twfth9/Krankenwagen_PCB_Demo/Production/Krankenwagen_PCB.step

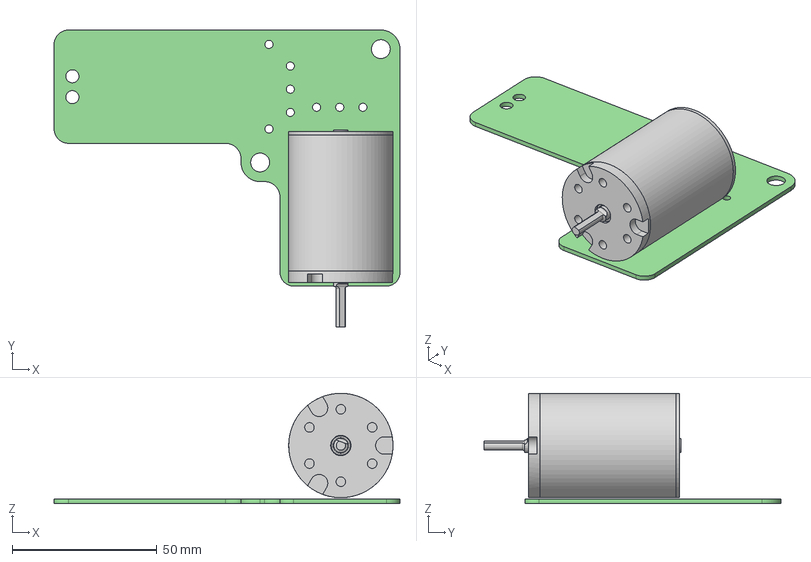
[picture p1: CAD file, 2022-10-02]
Production/Krankenwagen_PCB.step
119.4 x 102.5 x 38.1 mm
Krankenwagen_PCB PCB
