twfth9/Krankenwagen_PCB_Demo/Documentation/Krakenwagen 2021 Wiring Diagram.png

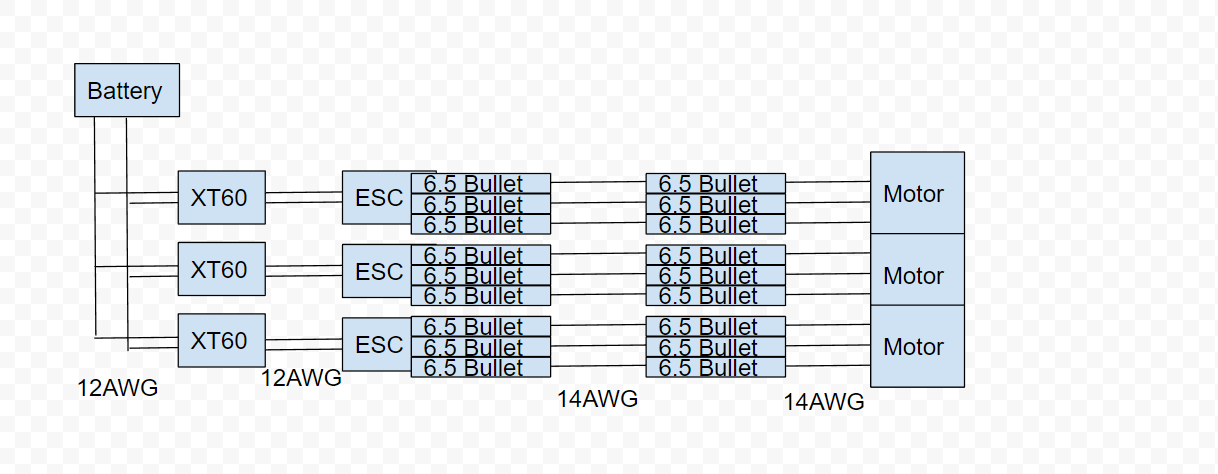
Documentation/Krakenwagen 2021 Wiring Diagram.png
