twfth9/Krankenwagen_PCB_Demo/Documentation/Drive SubAssembly.pdf

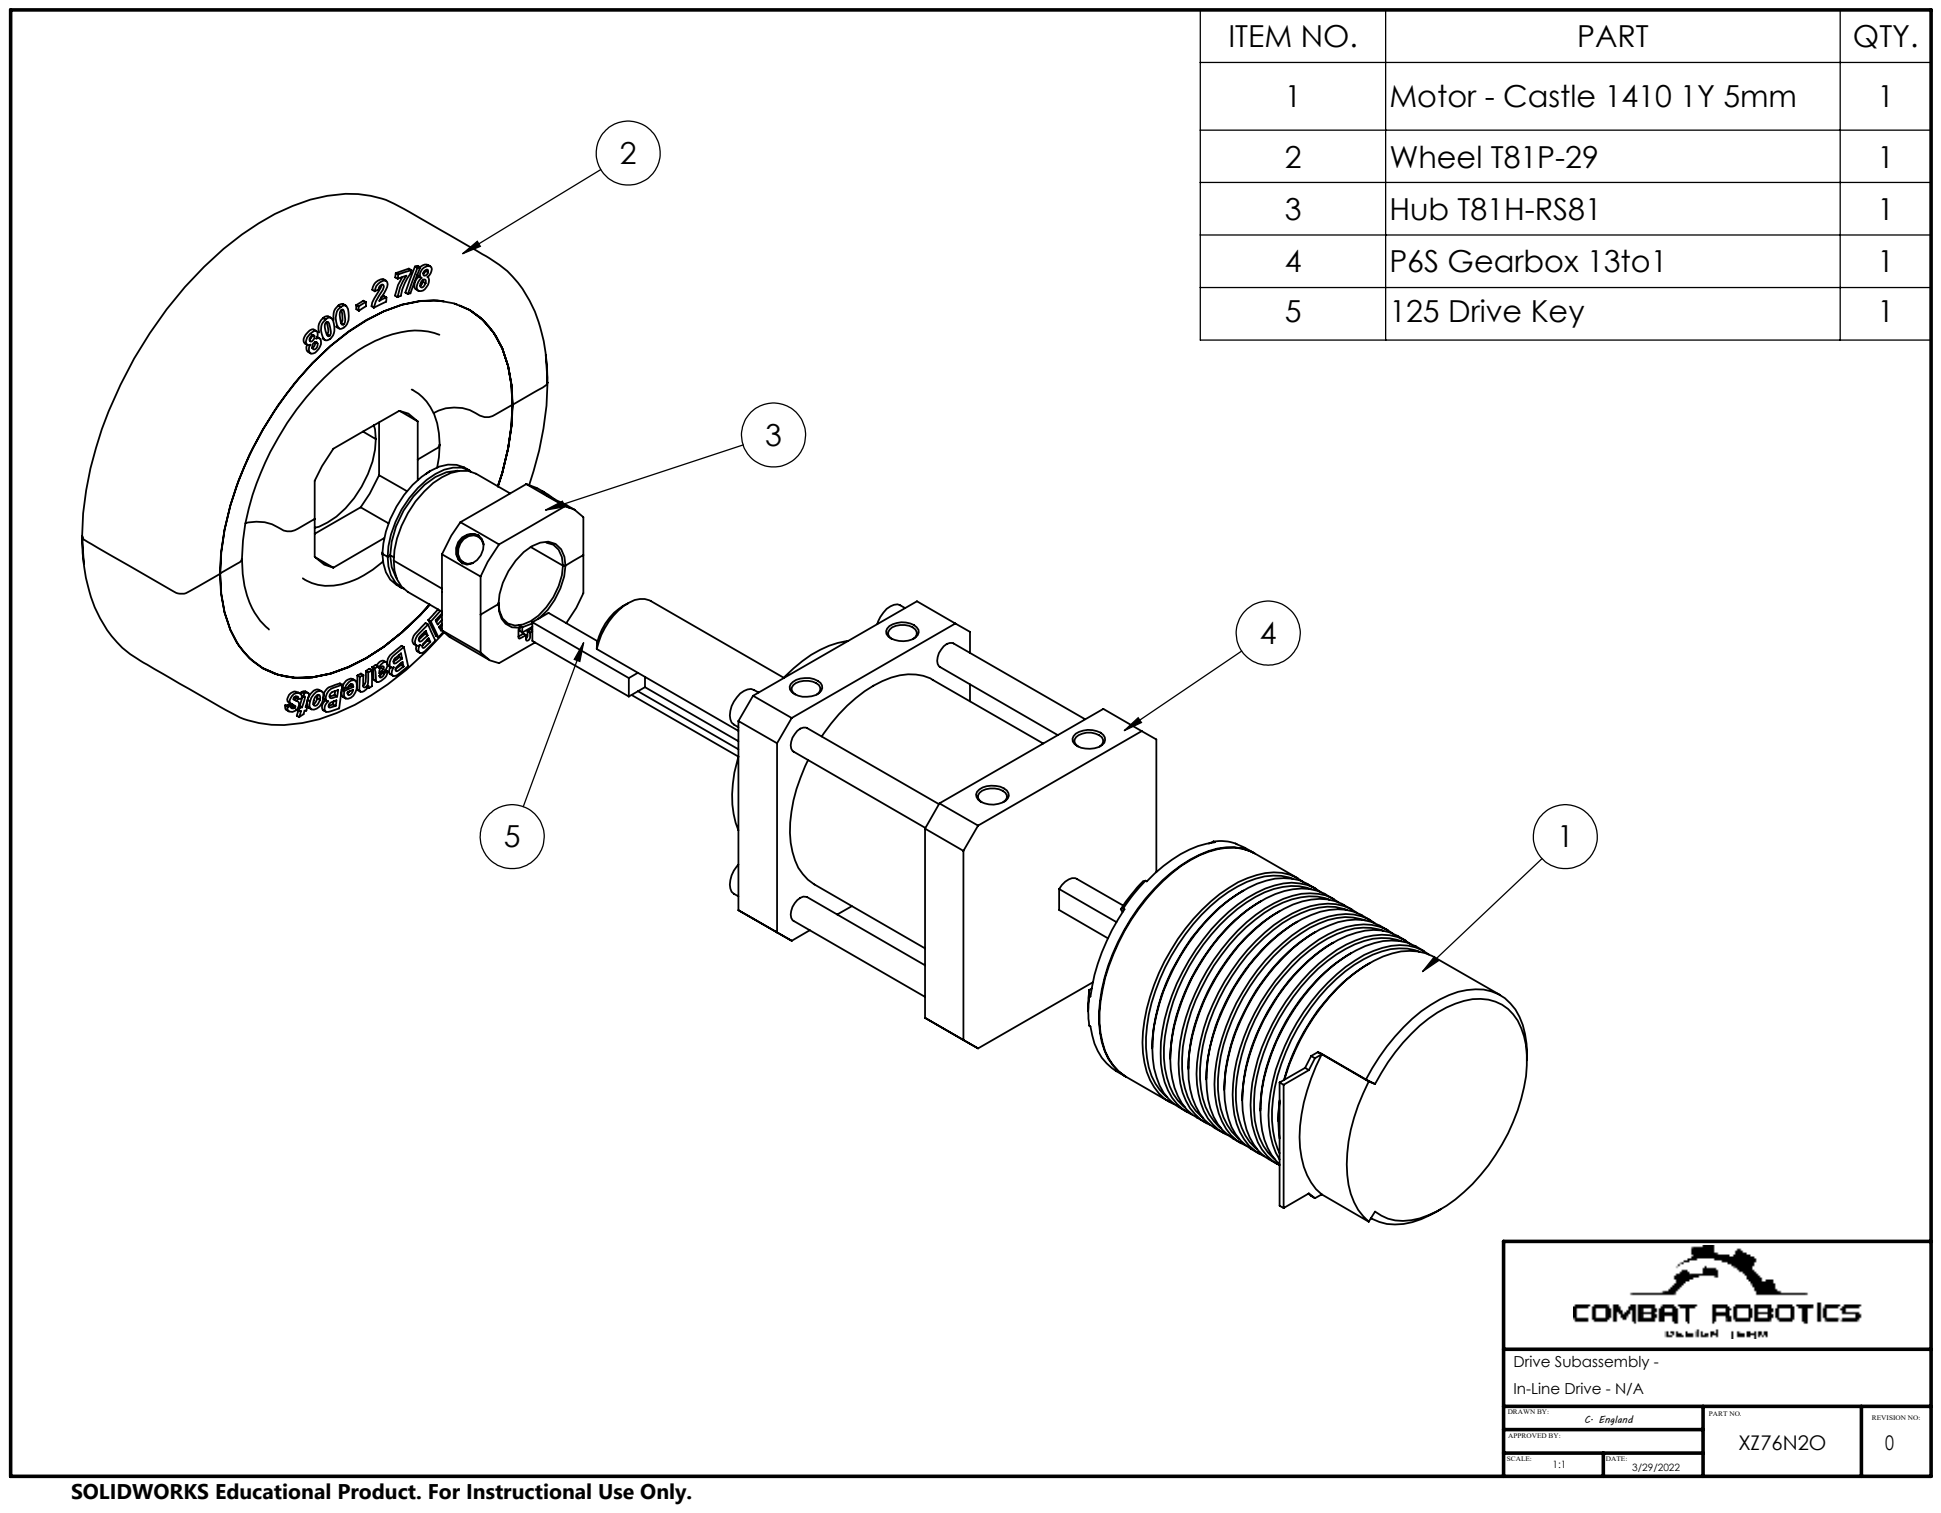
[picture p3: page 1]
0 SCALE:; DATE:; DRAWN BY:; PART NO.; C. England; REVISION NO:; XZ76N2O APPROVED BY:

ITEM NO. | PART | QTY.
1 | Motor - Castle 1410 1Y 5mm | 1
2 | Wheel T81P-29 | 1
3 | Hub T81H-RS81 | 1
4 | P6S Gearbox 13to1 | 1
5 | 125 Drive Key | 1

Drive Subassembly -
In-Line Drive - N/A

SOLIDWORKS Educational Product. For Instructional Use Only.
