twfth9/Krankenwagen_PCB_Demo/Documentation/Main Assembly.pdf

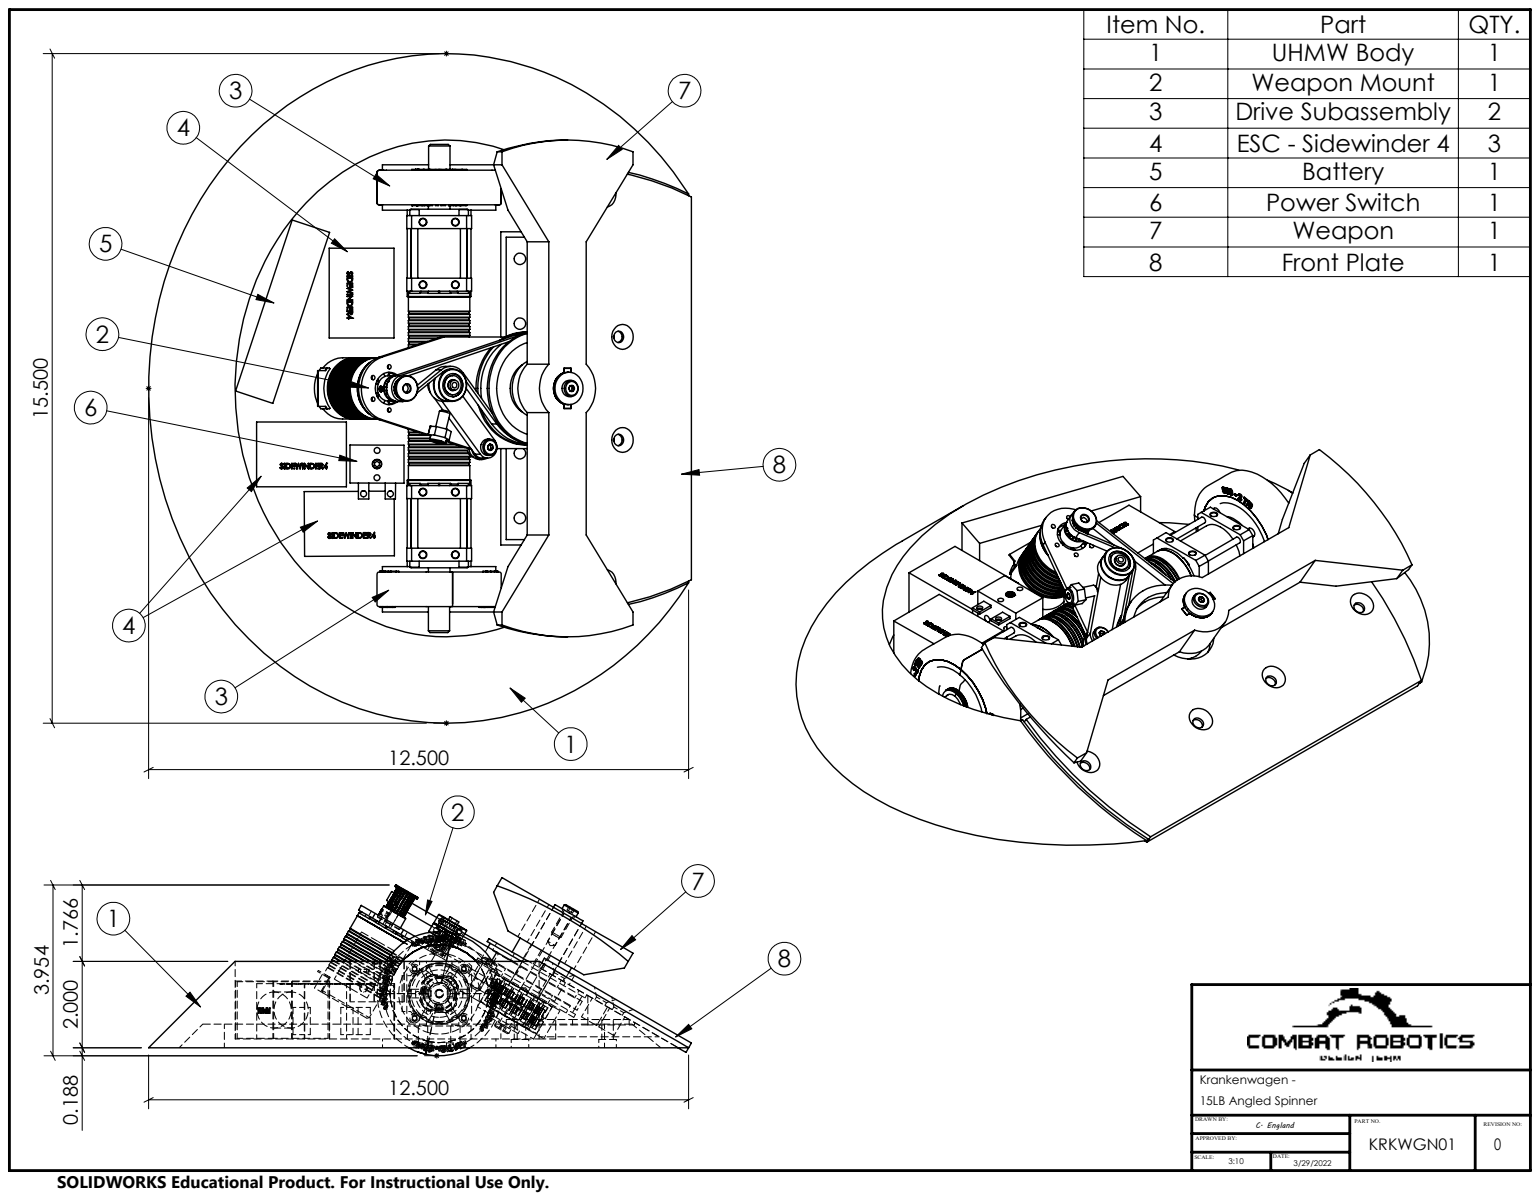
[picture p4: page 1]
0 SCALE:; DATE:; DRAWN BY:; PART NO.; Krankenwagen -; C. England; REVISION NO:; KRKWGN01 APPROVED BY:; 15LB Angled Spinner

Item No. | Part | QTY.
1 | UHMW Body | 1
2 | Weapon Mount | 1
3 | Drive Subassembly | 2
4 | ESC - Sidewinder 4 | 3
5 | Battery | 1
6 | Power Switch | 1
7 | Weapon | 1
8 | Front Plate | 1

SOLIDWORKS Educational Product. For Instructional Use Only.
