twfth9/Krankenwagen_PCB_Demo/Documentation/Weapon Shaft Assembly.pdf

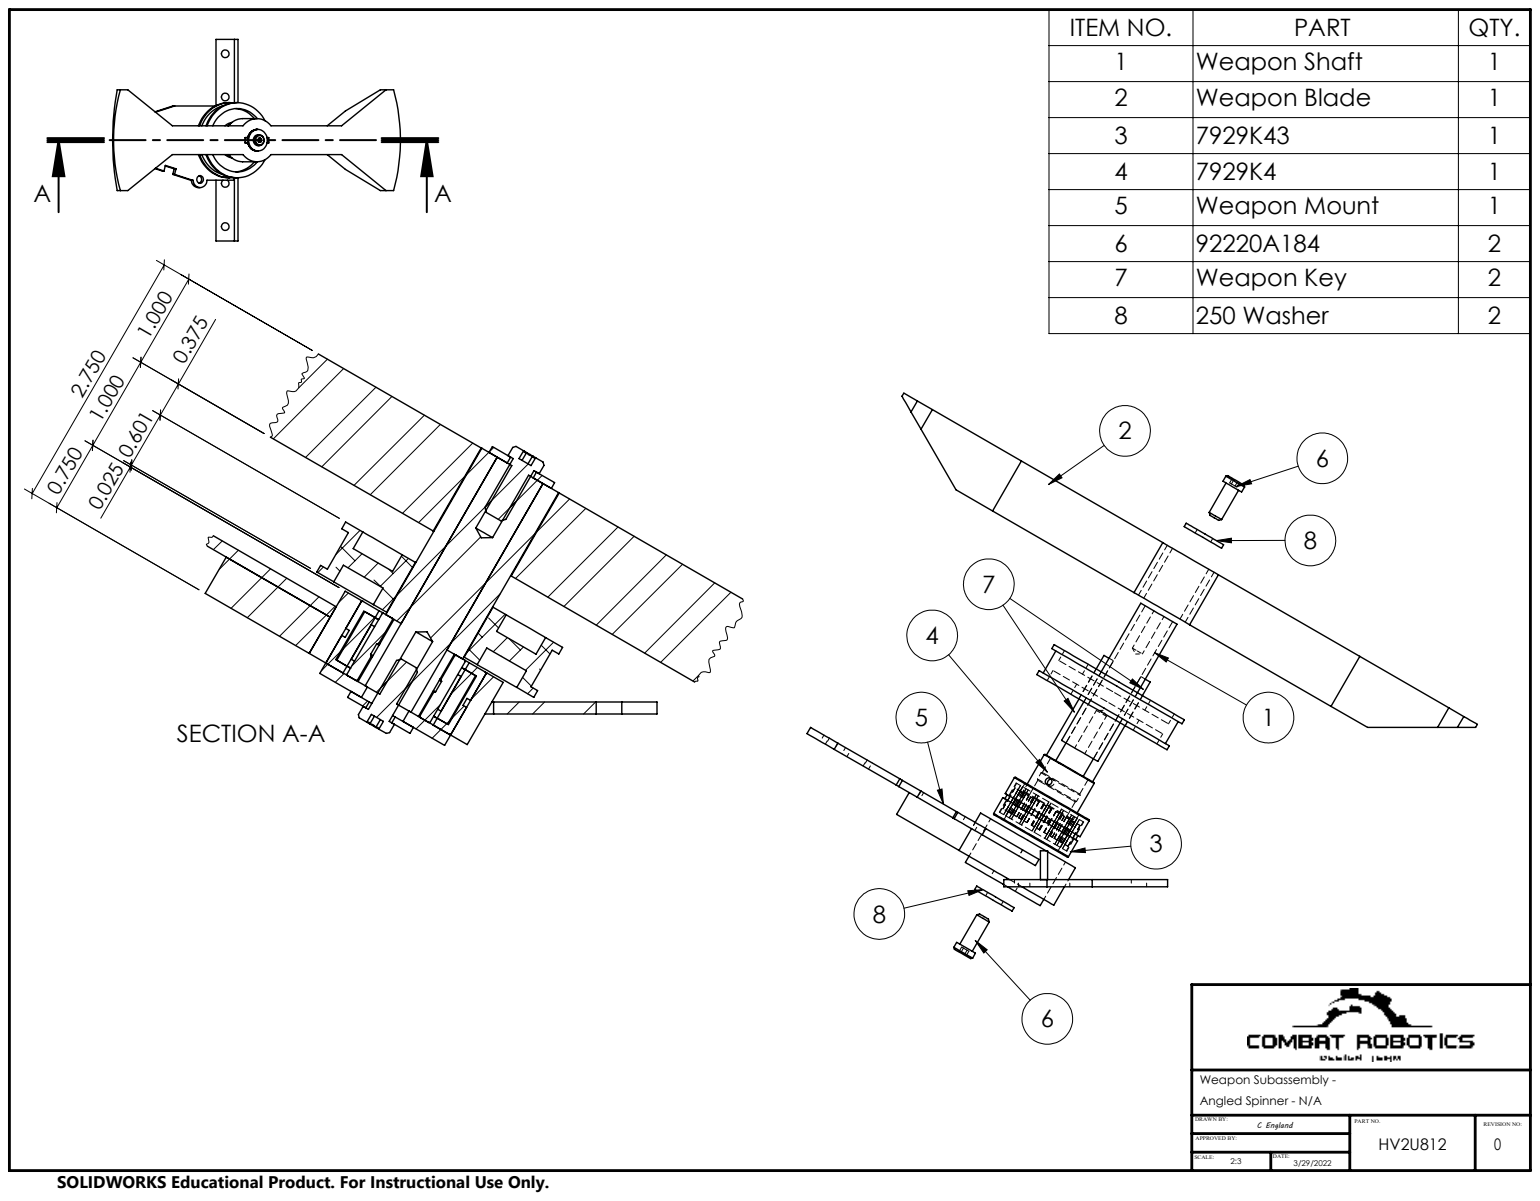
[picture p5: page 1]
SECTION A-A; 0 SCALE:; DATE:; DRAWN BY:; PART NO.; Weapon Subassembly -; C England; REVISION NO:; HV2U812 APPROVED BY:; Angled Spinner - N/A

ITEM NO. | PART | QTY.
1 | Weapon Shaft | 1
2 | Weapon Blade | 1
3 | 7929K43 | 1
4 | 7929K4 | 1
5 | Weapon Mount | 1
6 | 92220A184 | 2
7 | Weapon Key | 2
8 | 250 Washer | 2

SOLIDWORKS Educational Product. For Instructional Use Only.
