twfth9/Krankenwagen_PCB_Demo/Documentation/Body Plates.pdf

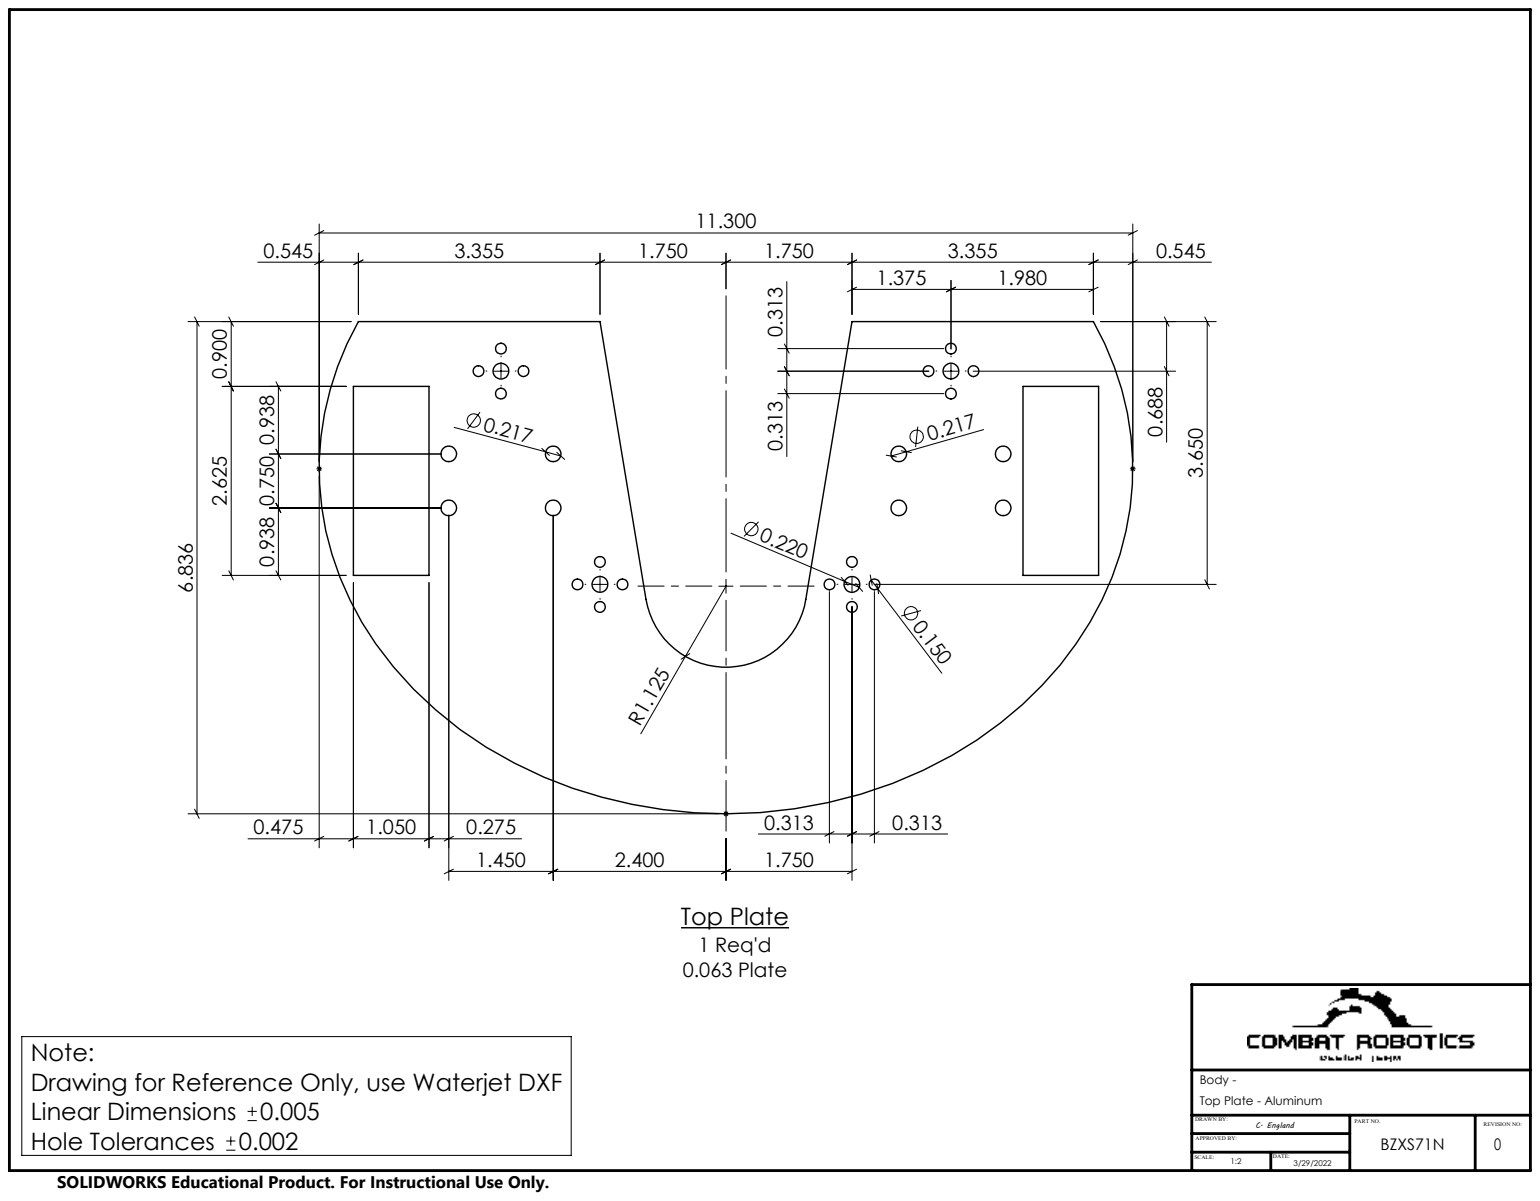
[picture p6: page 1]
Top Plate 1 Req'd 0.063 Plate; Linear Dimensions; Hole Tolerances; 0 SCALE:; DATE:; DRAWN BY:; PART NO.; C. England; REVISION NO:; BZXS71N APPROVED BY:

Note:
Drawing for Reference Only, use Waterjet DXF
SOLIDWORKS Educational Product. For Instructional Use Only.

Body -
Top Plate - Aluminum

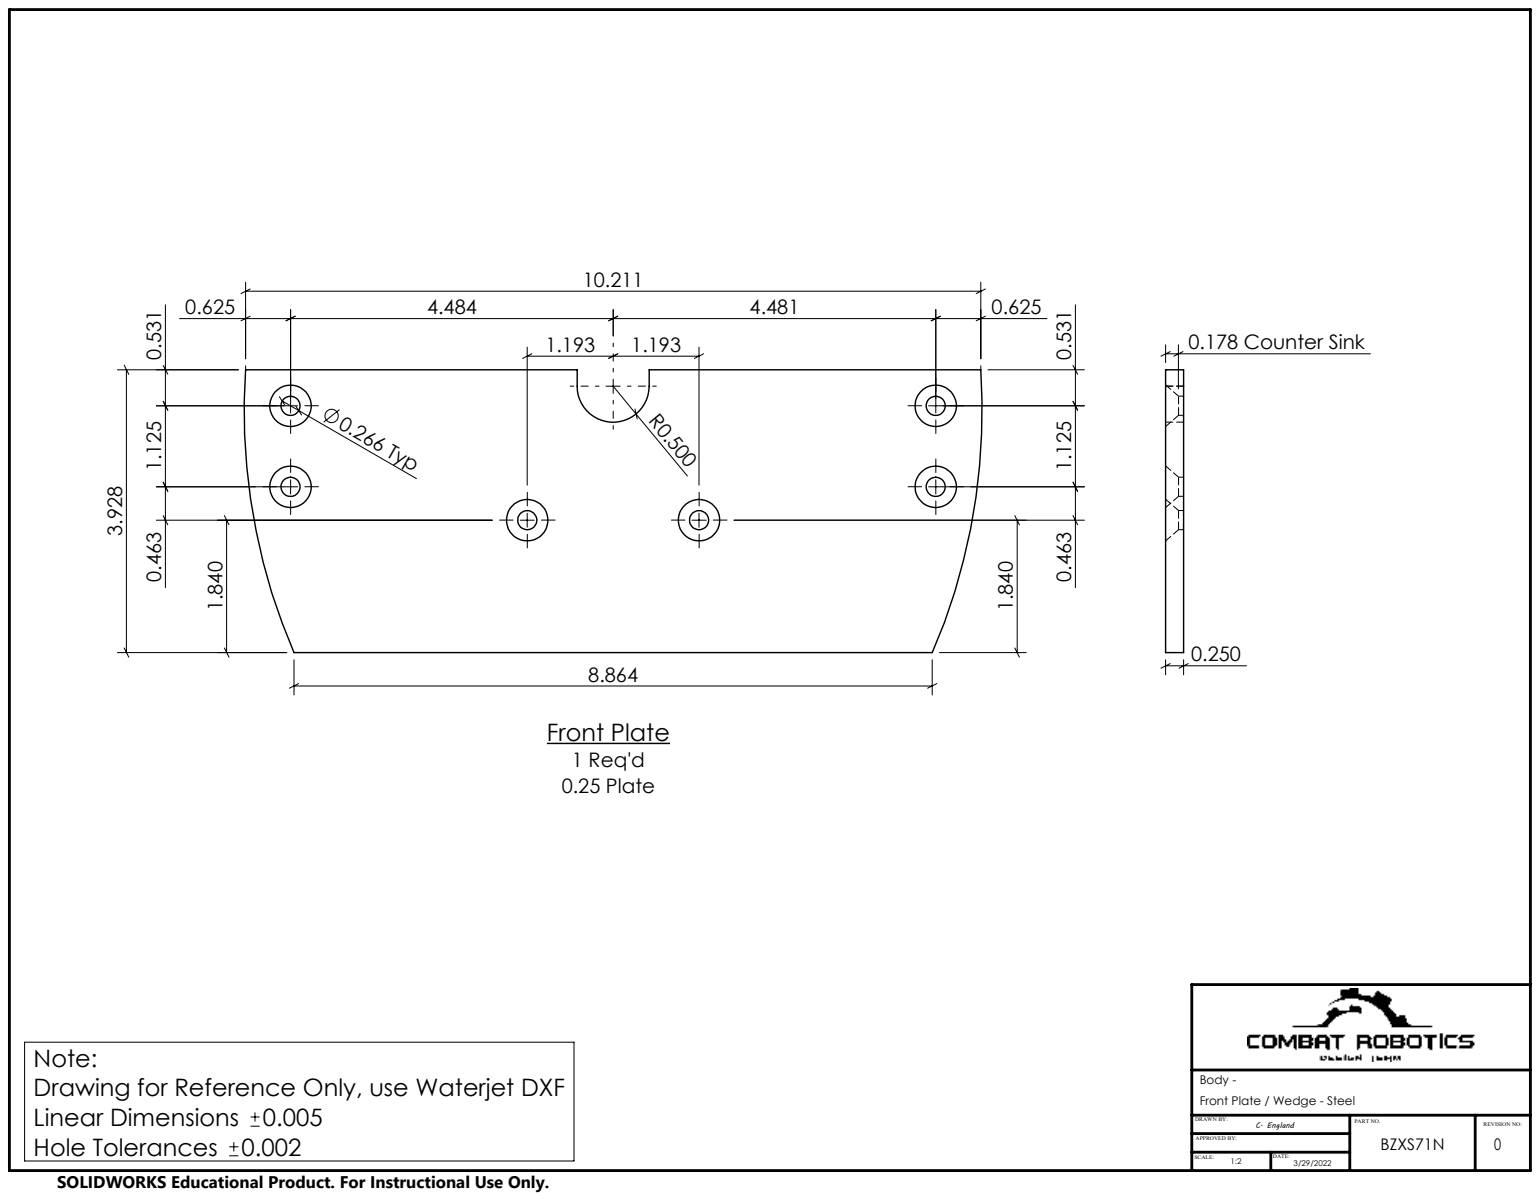
[picture p7: page 2]
0.266 Typ; Front Plate 1 Req'd 0.25 Plate; 0.178 Counter Sink; Linear Dimensions; Hole Tolerances; 0 SCALE:; DATE:; DRAWN BY:; PART NO.; C. England; REVISION NO:; BZXS71N APPROVED BY:

Note:
Drawing for Reference Only, use Waterjet DXF
SOLIDWORKS Educational Product. For Instructional Use Only.

Body -
Front Plate / Wedge - Steel
