twfth9/Krankenwagen_PCB_Demo/Documentation/UHMW Body.pdf

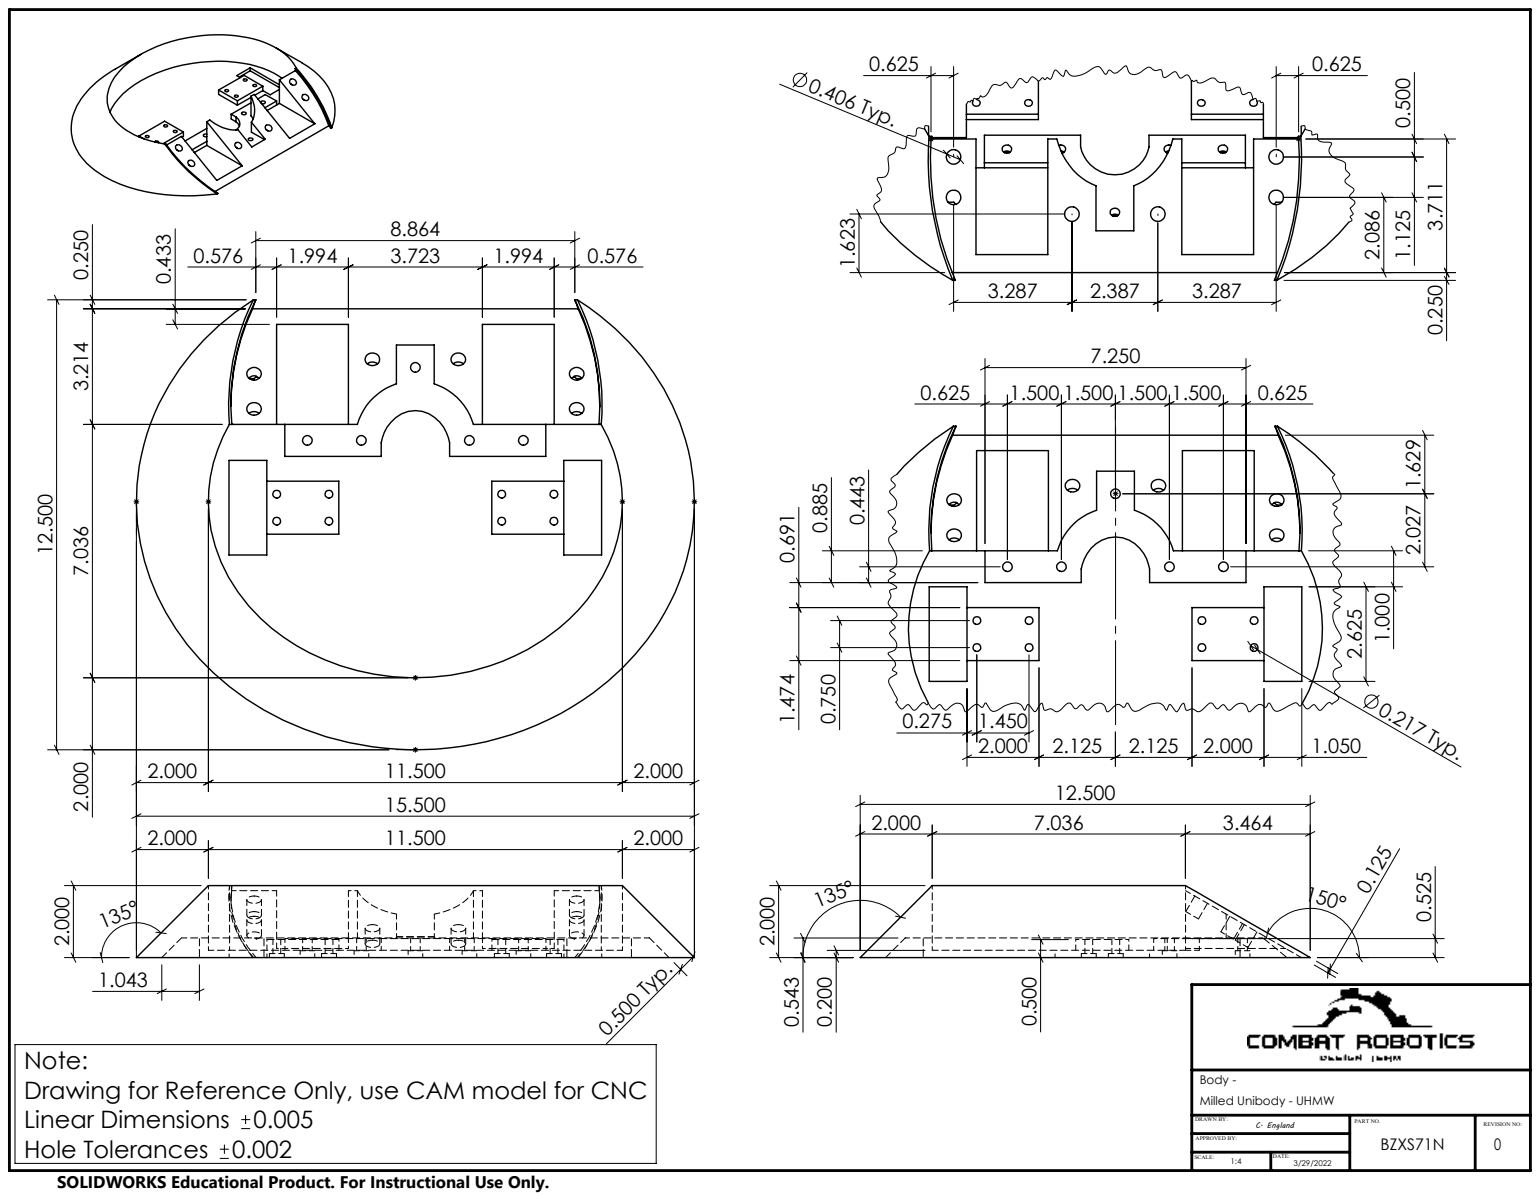
[picture p8: page 1]
0.500 Typ.; 0.406 Typ. 1.623; 0.217 Typ.; Linear Dimensions; Hole Tolerances; 0 SCALE:; DATE:; DRAWN BY:; PART NO.; C. England; REVISION NO:; BZXS71N APPROVED BY:

Note:
Drawing for Reference Only, use CAM model for CNC
SOLIDWORKS Educational Product. For Instructional Use Only.

Body -
Milled Unibody - UHMW
