twfth9/Krankenwagen_PCB_Demo/Documentation/Weapon Blade.pdf

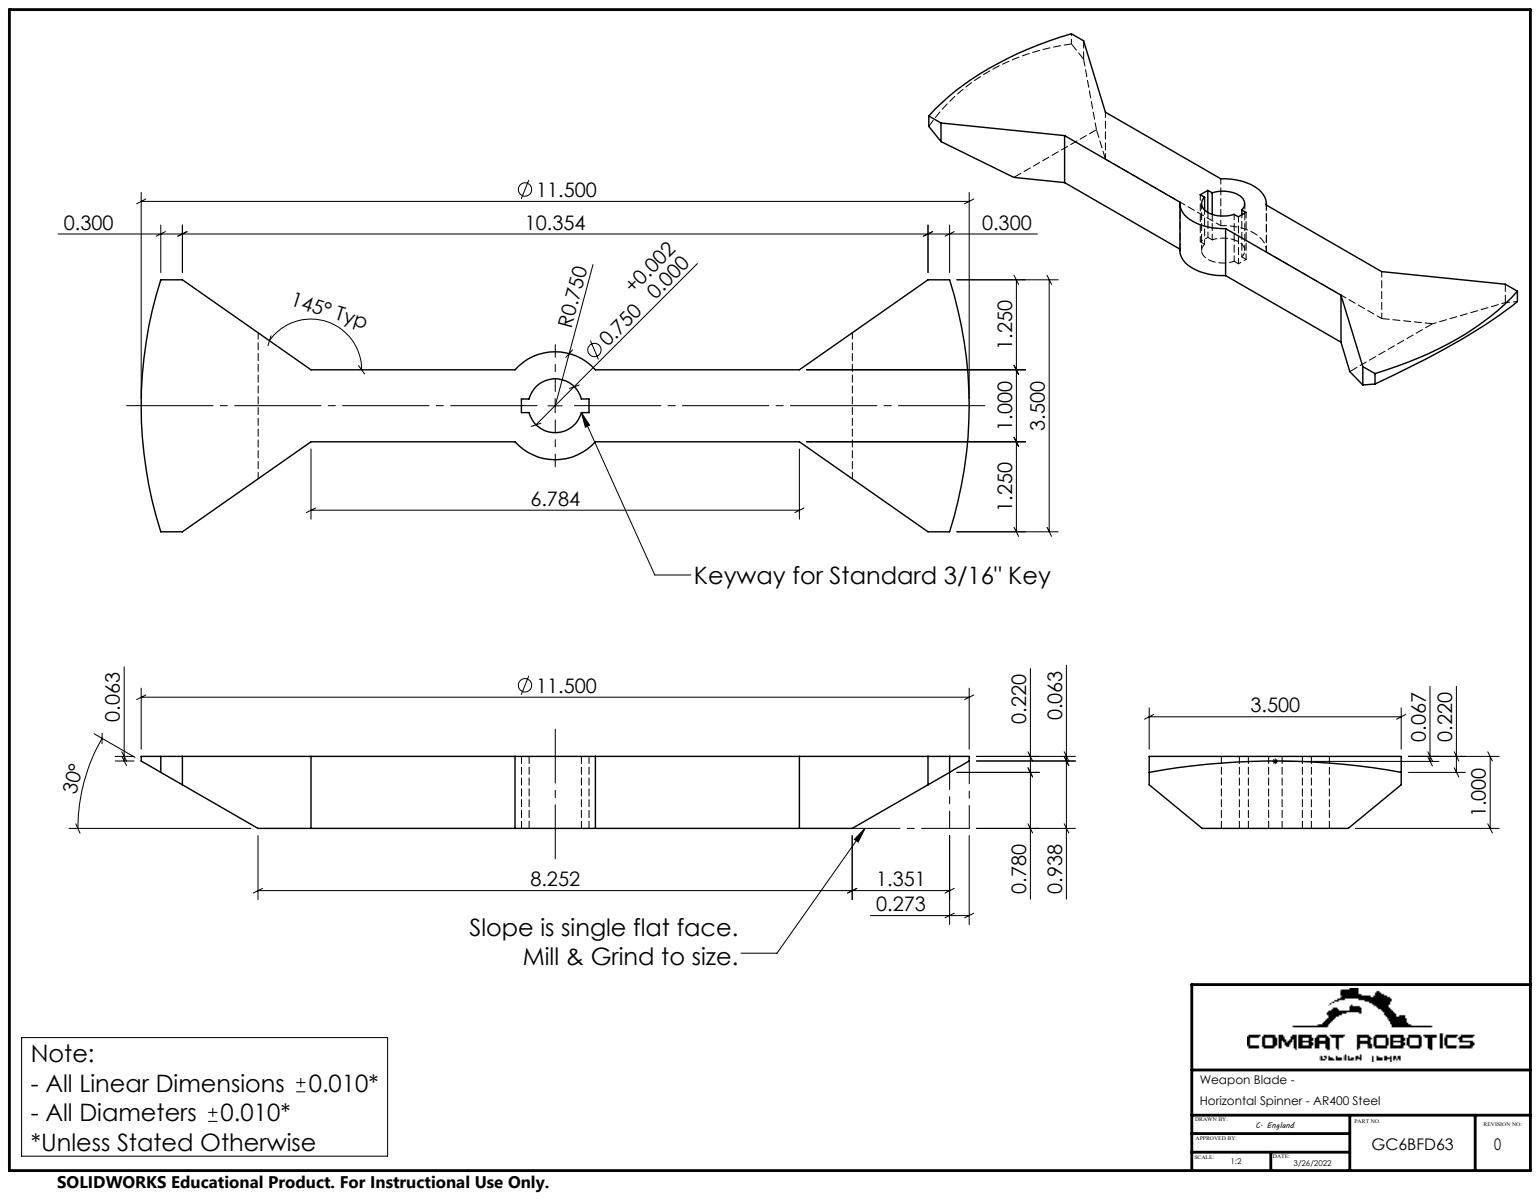
[picture p9: page 1]
145° Typ; - All Linear Dimensions; - All Diameters; *Unless Stated Otherwise; 0 SCALE:; DATE:; DRAWN BY:; PART NO.; C. England; REVISION NO:; GC6BFD63 APPROVED BY:

Keyway for Standard 3/16" Key

Slope is single flat face.
Mill & Grind to size.

Note:
SOLIDWORKS Educational Product. For Instructional Use Only.

Weapon Blade -
Horizontal Spinner - AR400 Steel
