twfth9/Krankenwagen_PCB_Demo/Documentation/Weapon Mount.pdf

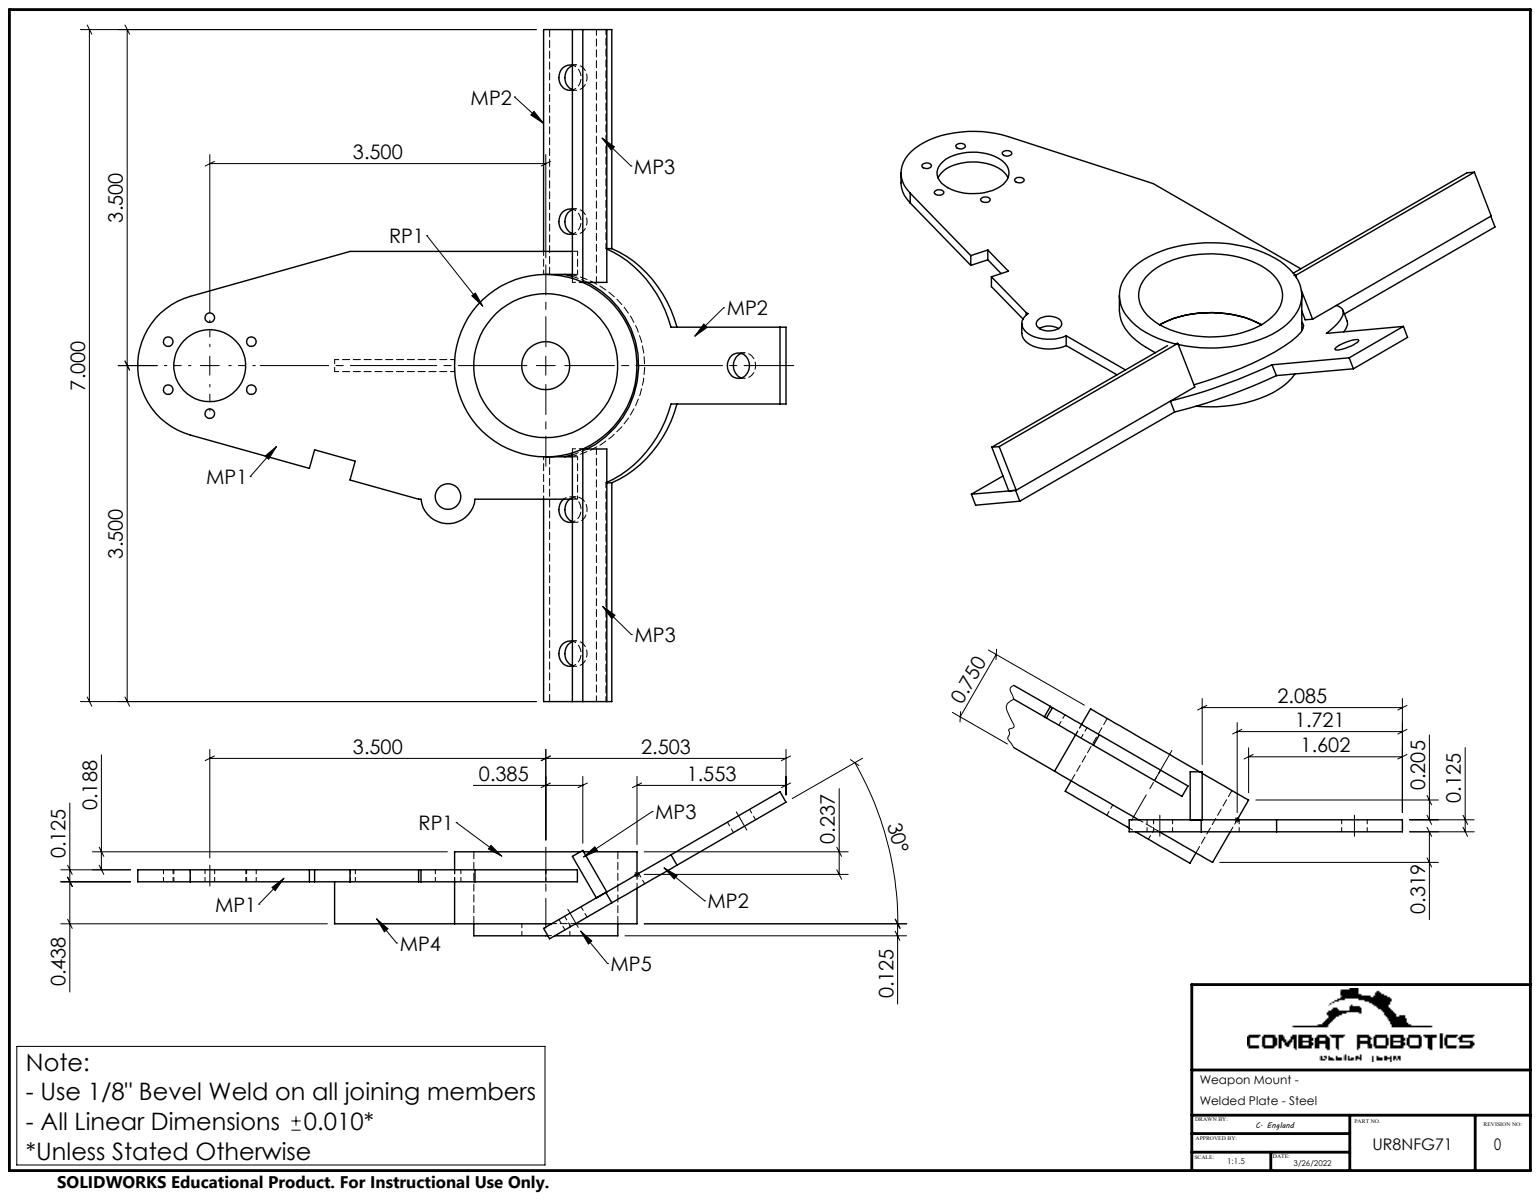
[picture p10: page 1]
- All Linear Dimensions; *Unless Stated Otherwise; 0 SCALE:; DATE:; DRAWN BY:; PART NO.; C. England; REVISION NO:; UR8NFG71 APPROVED BY:

Note:
- Use 1/8" Bevel Weld on all joining members
SOLIDWORKS Educational Product. For Instructional Use Only.

Weapon Mount -
Welded Plate - Steel

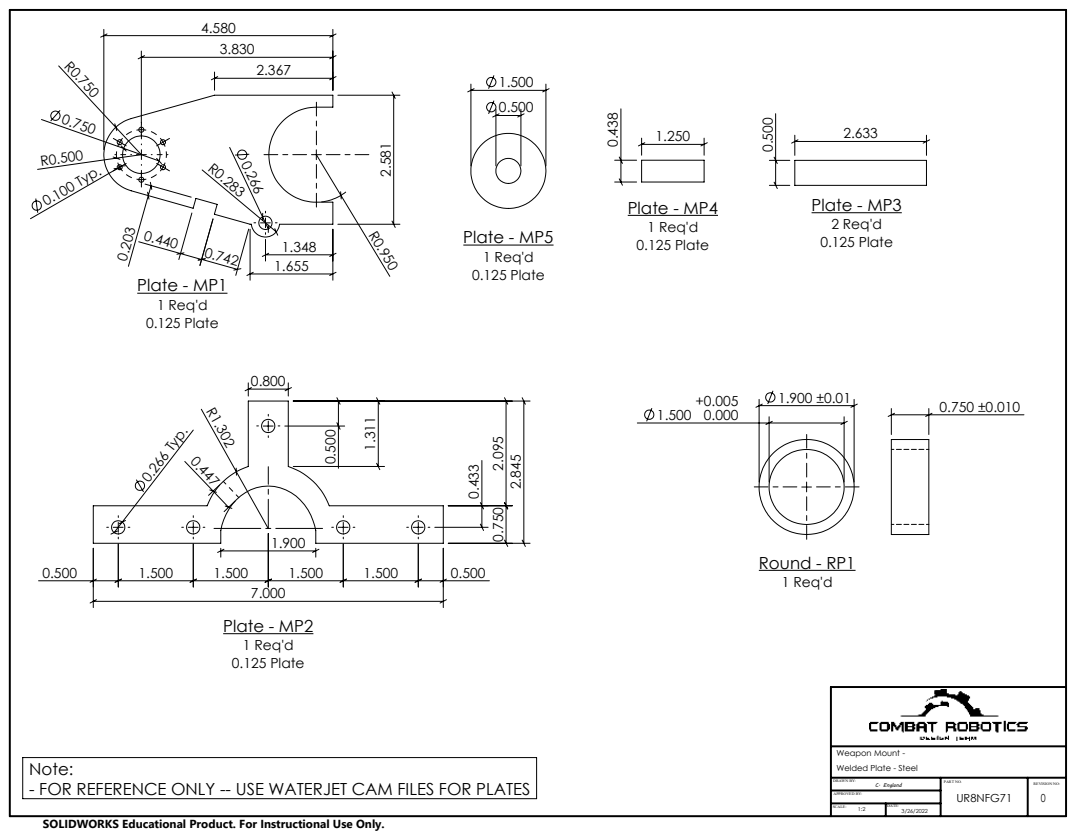
[picture p11: page 2]
0.100 Typ.; Plate - MP1 1 Req'd 0.125 Plate; Plate - MP5 1 Req'd 0.125 Plate; Plate - MP4 1 Req'd 0.125 Plate; Plate - MP3 2 Req'd 0.125 Plate; 0.266 Typ. R1.302; Plate - MP2 1 Req'd 0.125 Plate; Round - RP1 1 Req'd; - FOR REFERENCE ONLY -- USE WATERJET CAM FILES FOR PLATES; 0 SCALE:; DATE:; DRAWN BY:; PART NO.; C. England; REVISION NO:; UR8NFG71 APPROVED BY:

Weapon Mount -
Welded Plate - Steel

Note:
SOLIDWORKS Educational Product. For Instructional Use Only.
