twfth9/Krankenwagen_PCB_Demo/Documentation/Weapon Pulley.pdf

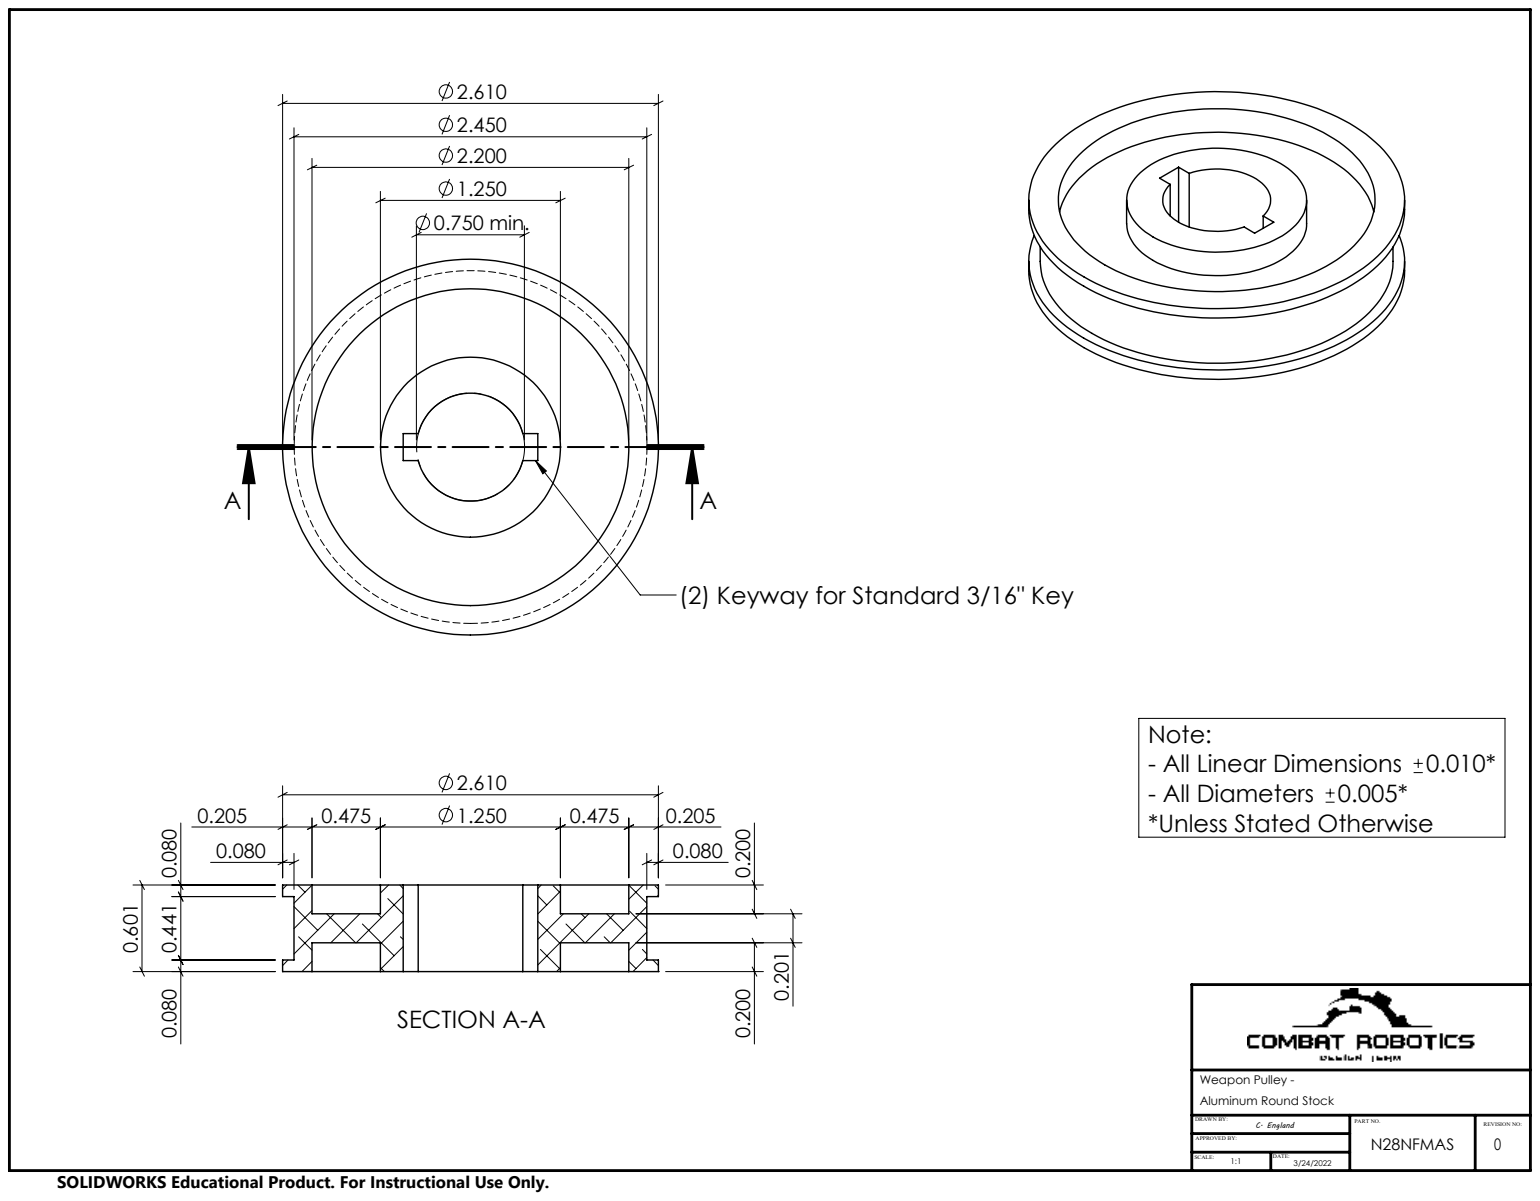
[picture p12: page 1]
0.750 min.; SECTION A-A; - All Linear Dimensions; - All Diameters; 0 SCALE:; DATE:; DRAWN BY:; PART NO.; C. England; REVISION NO:; N28NFMAS APPROVED BY:

(2) Keyway for Standard 3/16" Key

Note:
*Unless Stated Otherwise

Weapon Pulley -
Aluminum Round Stock

SOLIDWORKS Educational Product. For Instructional Use Only.
