twfth9/Krankenwagen_PCB_Demo/Documentation/Weapon Shaft 15lb.pdf

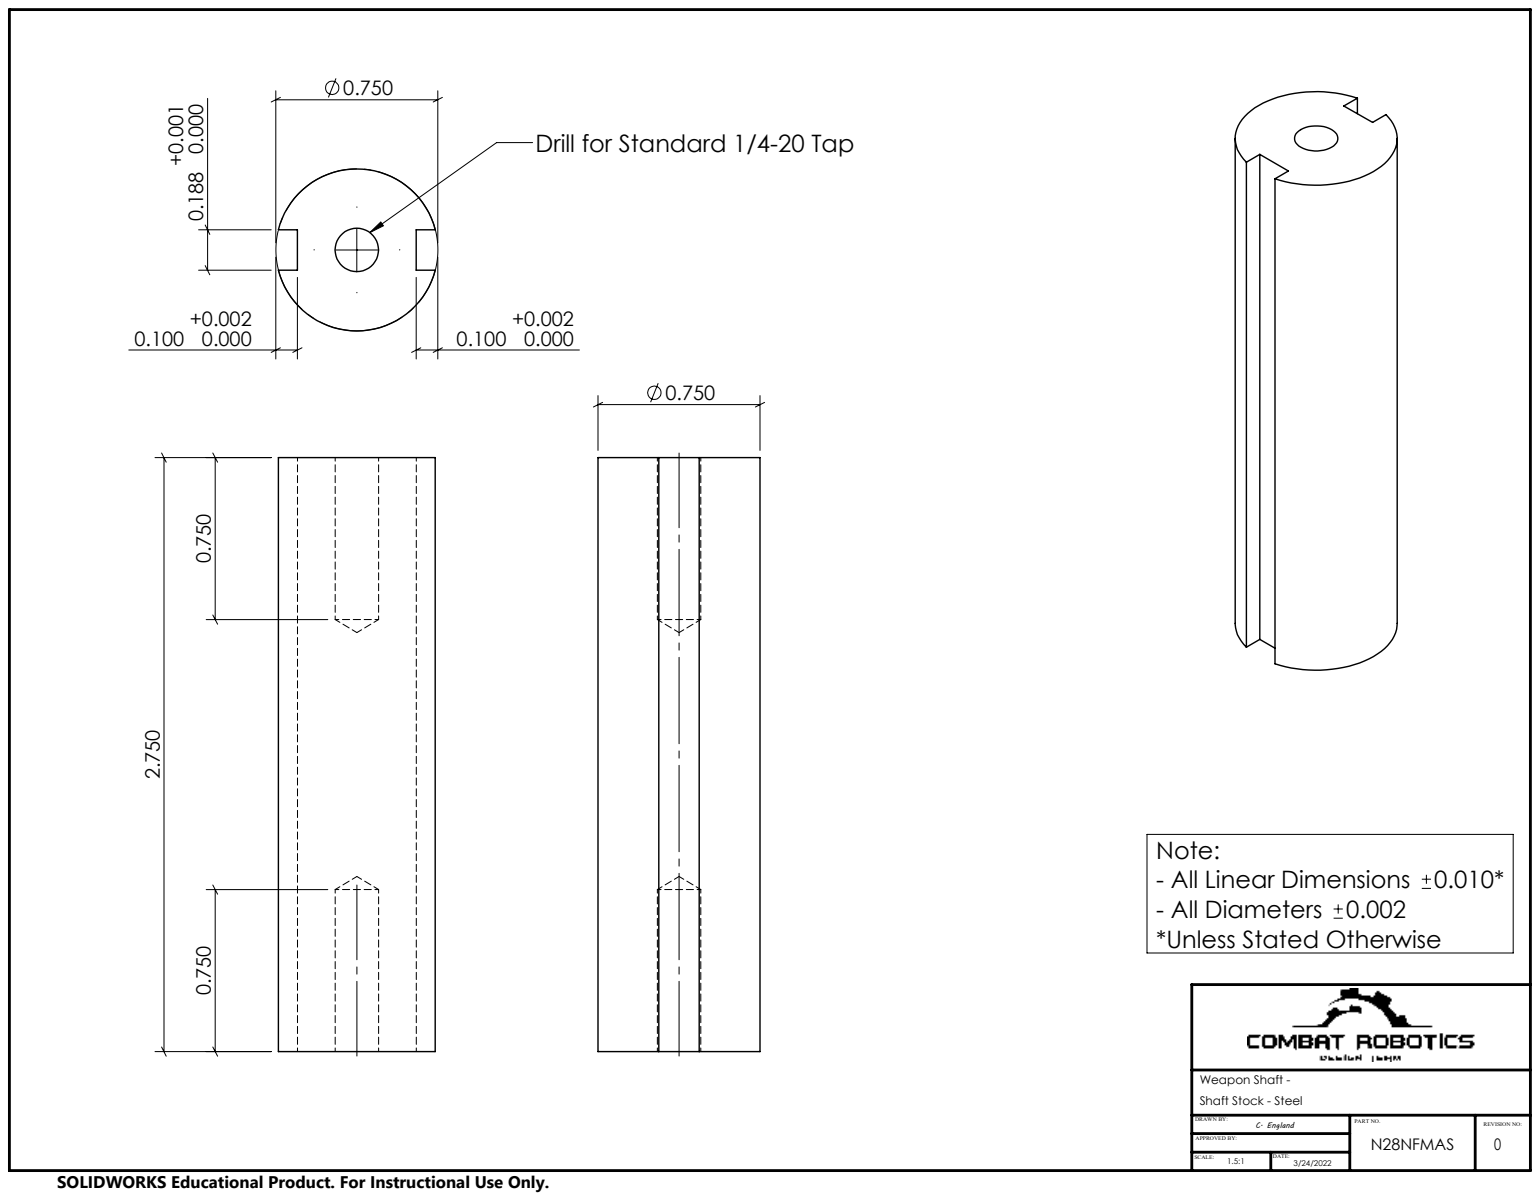
[picture p13: page 1]
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

Drill for Standard 1/4-20 Tap

Note:
*Unless Stated Otherwise

Weapon Shaft -
Shaft Stock - Steel

SOLIDWORKS Educational Product. For Instructional Use Only.
