twfth9/Krankenwagen_PCB_Demo/Hardware/Krankenwagen_PCB/Krankenwagen_PCB.kicad_pcb

## KiCad design Hardware/Krankenwagen_PCB/Krankenwagen_PCB.kicad_pcb (2022-10-02)

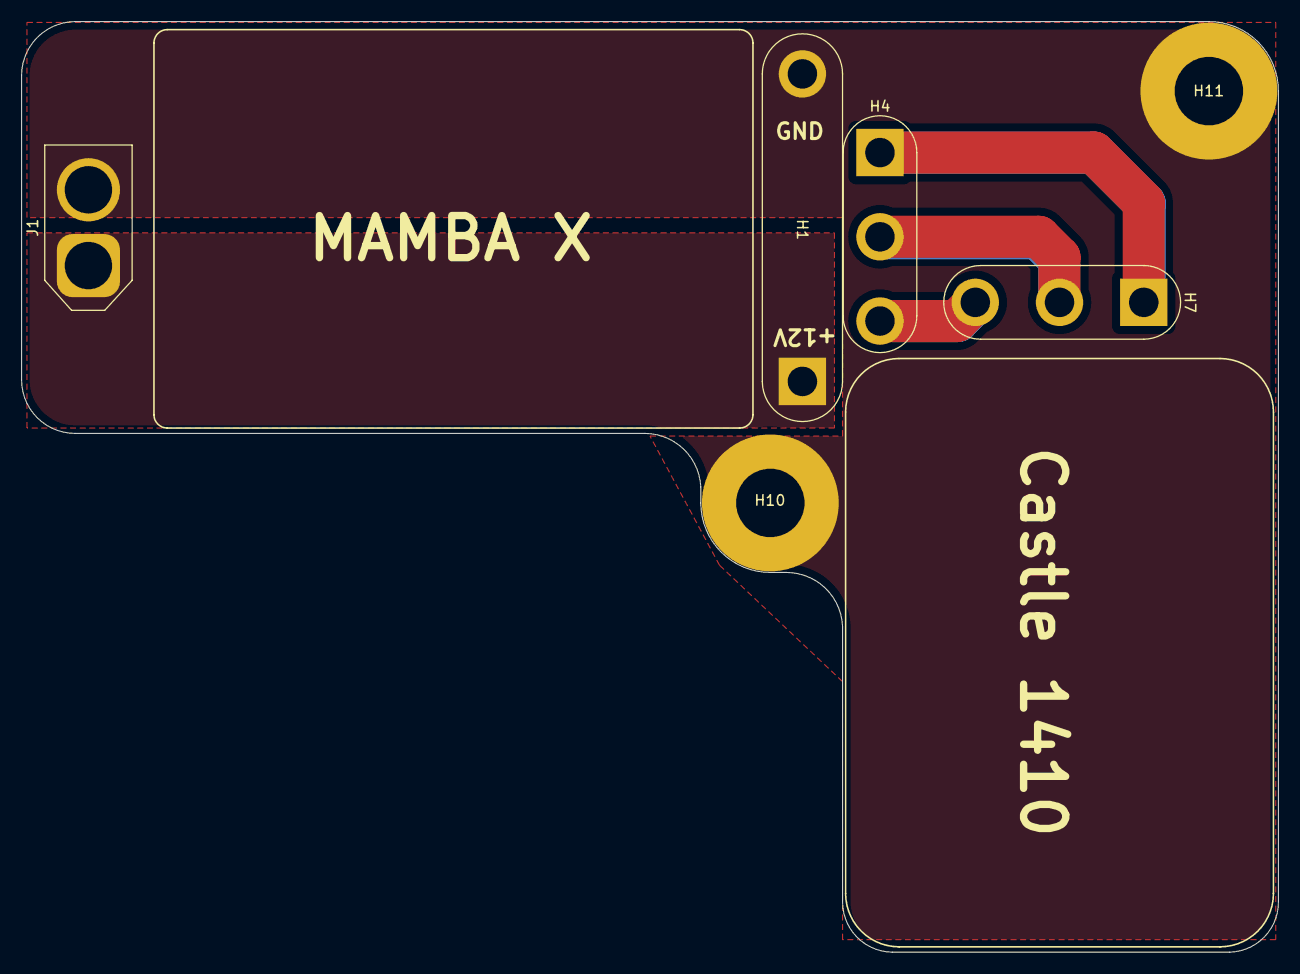
[picture p14: board Krankenwagen_PCB.kicad_pcb from above]

Board: 2 copper layers, 119.4 x 88.4 mm, 6 parts (0 on the bottom side), 5 nets.

Parts:
H1: 3.5mm Plated Holes; Solder Holes MAMBA X Power
H4, H7: 2.8mm Plated Holes; 2.8mm Solder Hole x3
H10, H11: MountingHole; MountingHole_6.5mm_Pad
J1: XT60-F; AMASS_XT60-F_1x02_P7.20mm_Vertical

Connections:
+12V: H1.1, J1.1
GND: H1.2, H10.1, H11.1, J1.2
unnamed: H4.1, H7.1
unnamed: H4.2, H7.2
unnamed: H4.3, H7.3
