twfth9/Krankenwagen_PCB_Demo/(commit log)

2022-10-02 Start of schematic, added documentation
    [Krankenwagen_PCB.kicad_pcb, Krankenwagen_PCB.kicad_sch]
2022-10-02 Completed schematic
    [Krankenwagen_PCB.kicad_pcb, Krankenwagen_PCB.kicad_sch]
2022-10-02 Created solder hole footprints
    [Krankenwagen_PCB.kicad_sch]
2022-10-02 Added XT60 footprints, assigned footprints
    [Krankenwagen_PCB.kicad_sch]
2022-10-02 Basic PCB completed, added logos to silkscreen
    [Krankenwagen_PCB.kicad_pcb, Krankenwagen_PCB.kicad_sch]
2022-10-02 Added mounting holes to PCB and Schematic
    [Krankenwagen_PCB.kicad_pcb]
2022-10-02 Generated step file of PCB
    [Krankenwagen_PCB.kicad_pcb, Krankenwagen_PCB.kicad_sch, Krankenwagen_PCB.step]
2022-10-02 Added title page info to PCB file
    [Krankenwagen_PCB.kicad_pcb]
